dimaib/Autolevel_sensor/schematic_pcb/Big_PP_stm32/123.png

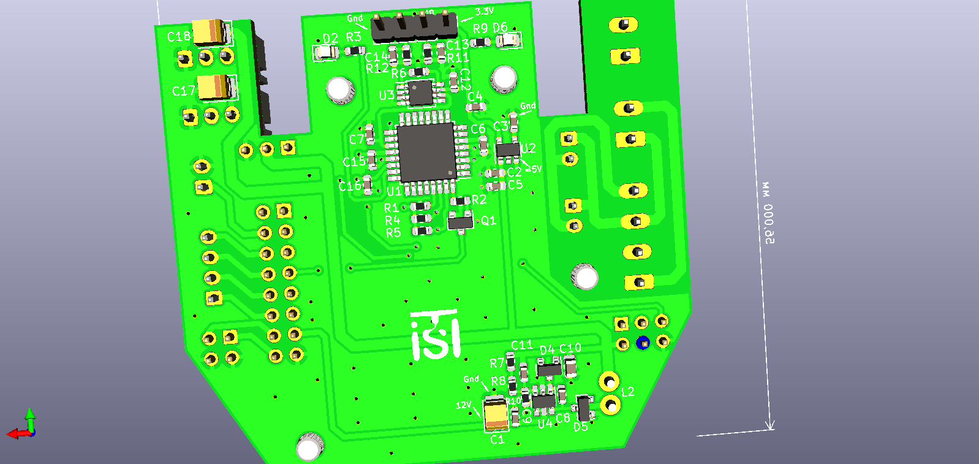
schematic_pcb/Big_PP_stm32/123.png
