dimaib/Autolevel_sensor/Программа INA333 AtSt_old/INA333/Output-Build.txt

------ Build started: Project: INA333, Configuration: Debug AVR ------
Build started.
Project "INA333.cproj" (default targets):
Target "PreBuildEvent" skipped, due to false condition; ('$(PreBuildEvent)'!='') was evaluated as (''!='').
Target "CoreBuild" in file "C:\Program Files (x86)\Atmel\Studio\7.0\Vs\Compiler.targets" from project "C:\Google Диск\02. Проекты_h\02. +3d_print\Датчик автоуровня\Программа INA333 AtSt\INA333\INA333\INA333.cproj" (target "Build" depends on it):
	Task "RunCompilerTask"
		Shell Utils Path C:\Program Files (x86)\Atmel\Studio\7.0\shellUtils
		C:\Program Files (x86)\Atmel\Studio\7.0\shellUtils\make.exe all --jobs 8 --output-sync 
		Building file: .././main.c
		Invoking: AVR/GNU C Compiler : 5.4.0
		"C:\Program Files (x86)\Atmel\Studio\7.0\toolchain\avr8\avr8-gnu-toolchain\bin\avr-gcc.exe"  -x c -funsigned-char -funsigned-bitfields -DDEBUG  -I"C:\Program Files (x86)\Atmel\Studio\7.0\Packs\atmel\ATmega_DFP\1.2.209\include"  -O1 -ffunction-sections -fdata-sections -fpack-struct -fshort-enums -g2 -Wall -mmcu=atmega8a -B "C:\Program Files (x86)\Atmel\Studio\7.0\Packs\atmel\ATmega_DFP\1.2.209\gcc\dev\atmega8a" -c -std=gnu99 -MD -MP -MF "main.d" -MT"main.d" -MT"main.o"   -o "main.o" ".././main.c" 
		Finished building: .././main.c
		Building target: INA333.elf
		Invoking: AVR/GNU Linker : 5.4.0
		"C:\Program Files (x86)\Atmel\Studio\7.0\toolchain\avr8\avr8-gnu-toolchain\bin\avr-gcc.exe" -o INA333.elf  main.o   -Wl,-Map="INA333.map" -Wl,--start-group -Wl,-lm  -Wl,--end-group -Wl,--gc-sections -mmcu=atmega8a -B "C:\Program Files (x86)\Atmel\Studio\7.0\Packs\atmel\ATmega_DFP\1.2.209\gcc\dev\atmega8a"  
		Finished building target: INA333.elf
		"C:\Program Files (x86)\Atmel\Studio\7.0\toolchain\avr8\avr8-gnu-toolchain\bin\avr-objcopy.exe" -O ihex -R .eeprom -R .fuse -R .lock -R .signature -R .user_signatures  "INA333.elf" "INA333.hex"
		"C:\Program Files (x86)\Atmel\Studio\7.0\toolchain\avr8\avr8-gnu-toolchain\bin\avr-size.exe" "INA333.elf"
		   text	   data	    bss	    dec	    hex	filename
		   2172	     30	      0	   2202	    89a	INA333.elf
	Done executing task "RunCompilerTask".
	Task "RunOutputFileVerifyTask"
				Program Memory Usage 	:	2202 bytes   26,9 % Full
				Data Memory Usage 		:	30 bytes   2,9 % Full
				Warning: Memory Usage estimation may not be accurate if there are sections other than .text sections in ELF file
	Done executing task "RunOutputFileVerifyTask".
Done building target "CoreBuild" in project "INA333.cproj".
Target "PostBuildEvent" skipped, due to false condition; ('$(PostBuildEvent)' != '') was evaluated as ('' != '').
Target "Build" in file "C:\Program Files (x86)\Atmel\Studio\7.0\Vs\Avr.common.targets" from project "C:\Google Диск\02. Проекты_h\02. +3d_print\Датчик автоуровня\Программа INA333 AtSt\INA333\INA333\INA333.cproj" (entry point):
Done building target "Build" in project "INA333.cproj".
Done building project "INA333.cproj".

Build succeeded.
========== Build: 1 succeeded or up-to-date, 0 failed, 0 skipped ==========
