dimaib/Autolevel_sensor/schematic_pcb/Big_PP_NEW_fix/Спецификация.xlsx

Спецификация платы экструдера
На схеме | Номинал | Артикул | Ссылка | Цена, шт | Кол-во | Кол-во комплектов | Цена, общ
C2 | 10uF | 293D106X9020B2TE3 | https://www.chipdip.ru/product0/8085431345 | 14.00 ₽ | 1 | 10 | 140.00 ₽
C3 | 20nF | GRM188R71H223KA01D | https://www.chipdip.ru/product/grm188r71h223k | 2.00 ₽ | 1 | 10 | 20.00 ₽
C4 | 470pF | GRM1885C1H471JA01D | https://www.chipdip.ru/product/grm1885c1h471j | 2.00 ₽ | 1 | 10 | 20.00 ₽
C5 | 0.1uF | GRM188R71H104KA93D | https://www.chipdip.ru/product/grm188r71h104k | 8.00 ₽ | 1 | 10 | 80.00 ₽
C6 | 22uF | GRM21BR60J226ME39L | https://www.chipdip.ru/product/grm21br60j226m | 10.00 ₽ | 1 | 10 | 100.00 ₽
C14 | 10uF | GRM188R61E106MA73D | https://www.chipdip.ru/product/grm188r61e106m | 12.00 ₽ | 1 | 10 | 120.00 ₽
> C1, C7-C12, C15 | 1uF | GRM188R61E105KAADD | https://www.chipdip.ru/product/grm188r61e105k | 5.00 ₽ | 8 | 10 | 400.00 ₽
D1 | Диод Шоттки | B340A-E3/61T | https://www.chipdip.ru/product/b340a-e3-61t-2 | 11.00 ₽ | 1 | 10 | 110.00 ₽
D2 | LED зелёный | GNL-3012GD | https://www.chipdip.ru/product/gnl-3012gd | 5.00 ₽ | 1 | 10 | 50.00 ₽
D3 | LED жёлтый | KP-2012EC | https://www.chipdip.ru/product/gnl-3012yd | 5.00 ₽ | 1 | 10 | 50.00 ₽
> D4, D5 | AD5160BRJZ | AD5160BRJZ10-R2 | https://www.chipdip.ru/product/ad5160brjz10-r2-2 | 110.00 ₽ | 2 | 10 | 2200.00 ₽
D6 | BAS321 | BAS321.115 | https://www.chipdip.ru/product/bas321.115 | 8.00 ₽ | 1 | 10 | 80.00 ₽
D7 | SP0503 | SP0503BAHTG | https://www.chipdip.ru/product1/8001783912 | 19.00 ₽ | 1 | 10 | 190.00 ₽
J15 | USB_B_Micro | USB/M-1J (DS1104) | https://www.chipdip.ru/product/usb-m-1j | 22.00 ₽ | 1 | 10 | 220.00 ₽
L1 | 3.3uH | RLB0914-3R3ML, 3.3 мкГн | https://www.chipdip.ru/product/rlb0914-3r3ml | 25.00 ₽ | 1 | 10 | 250.00 ₽
Q1 | BC817 | BC817-16.215 | https://www.chipdip.ru/product/bc817-16-nxp | 3.00 ₽ | 1 | 10 | 30.00 ₽
R1 | 150k | 0.1Вт 0603 150 кОм, 1% | https://www.chipdip.ru/product0/9000079764 | 0.90 ₽ | 1 | 10 | 9.00 ₽
R2 | 47k | 0.1Вт 0603 47 кОм, 1% | https://www.chipdip.ru/product0/9000079752 | 0.90 ₽ | 1 | 10 | 9.00 ₽
R3 | 24k | 0.1Вт 0603 24 кОм, 1% | https://www.chipdip.ru/product0/9000079745 | 0.90 ₽ | 1 | 10 | 9.00 ₽
R5 | 1.8k | 0.1Вт 0603 1.8 кОм, 1% | https://www.chipdip.ru/product0/9000079718 | 0.90 ₽ | 1 | 10 | 9.00 ₽
> R4, R6, R8, R10, R12 | 10k | 0.063Вт 0603 10 кОм, 1% | https://www.chipdip.ru/product0/9000079736 | 0.90 ₽ | 5 | 10 | 45.00 ₽
> R7, R9, R11 | 360 | 0.1Вт 0603 360 Ом, 1% | https://www.chipdip.ru/product0/9000079629 | 0.90 ₽ | 3 | 10 | 27.00 ₽
R13 | 82 | 0.1Вт 0603 82 Ом, 1% | https://www.chipdip.ru/product0/9000079614 | 0.90 ₽ | 1 | 10 | 9.00 ₽
RV1 | 10k | 3296W-1-103LF | https://www.chipdip.ru/product/3296w-1-103 | 70.00 ₽ | 1 | 10 | 700.00 ₽
RV2 | 100 | 3224W-1-101E | https://www.chipdip.ru/product/3224w-1-101e | 90.00 ₽ | 1 | 10 | 900.00 ₽
U1 | TPS54332 | TPS54332DDAR | https://www.chipdip.ru/product/tps54332dda | 96.00 ₽ | 1 | 10 | 960.00 ₽
U2 | AP1117-33 | AMS1117-3.3 | https://www.chipdip.ru/product/ams1117-3.3 | 16.00 ₽ | 1 | 10 | 160.00 ₽
U3 | ATmega8A-AU | ATmega8A-AU | https://www.chipdip.ru/product/atmega8a-au | 90.00 ₽ | 1 | 10 | 900.00 ₽
U4 | CP2102 | CP2102-GMR | https://www.chipdip.ru/product/cp2102-gmr | 110.00 ₽ | 1 | 10 | 1100.00 ₽
U5 | INA333 | INA333AIDGKT | https://www.chipdip.ru/product/ina333aidgkt | 180.00 ₽ | 1 | 10 | 1800.00 ₽
 |  |  |  |  |  | Итого: | 10697.00 ₽
