dimaib/Autolevel_sensor/schematic_pcb/Big_PP_stm32/_23.FCStd

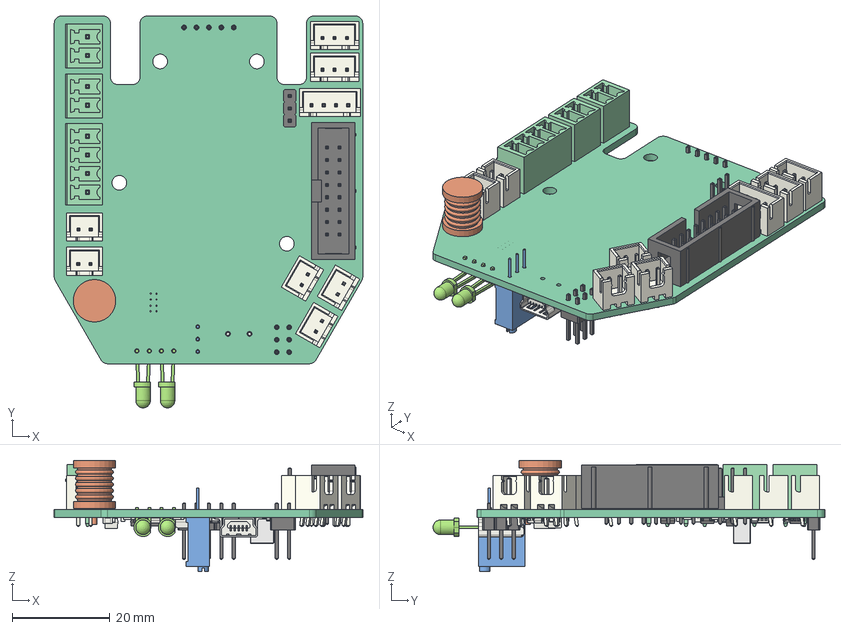
[picture p2: CAD file, 2022-04-17]
schematic_pcb/Big_PP_stm32/_23.FCStd
63.0 x 80.0 x 22.7 mm
Pcb
J3_IDC_Header_2x08_P254mm_Vertical_5DCC8D21
L1_L_Radial_D8.7mm_P5.00mm_Fastron_07HCP_5DCE0A41
J5_JST_B3B_XH_A_5DCC6F4B
J8_JST_B2B_XH_A_5DCD43AC
J7_JST_B2B_XH_A_5DCD4424
J1_JST_B3B_XH_A_5DCC6FC6
J4_JST_B4B_XH_A_5D9DB084
J6_JST_B2B_XH_A_5D9D945D
J9_PinHeader_1x03_P254mm_Vertical_5D88C4DF
J10_MCV_01x04_G_3_81mm_5D88C476
J11_MCV_01x02_G_3_81mm_5D88C444
J12_MCV_01x02_G_3_81mm_5D88C412
J13_JST_B2B_XH_A_5D88C3EA
J14_JST_B2B_XH_A_5D88C3C2
User Library-3224W
D2_LED_D3.0mm_Horizontal_O6.35mm_Z2.0mm_5DCFC488
D3_LED_D3.0mm_Horizontal_O6.35mm_Z2.0mm_5DCD08B7
J2_PinHeader_2x03_P254mm_Vertical_5D88C5C6
D1_D_SMA_5DCE03F9
RV1_Potentiometer_Bourns_3296W_Vertical_5D9DDB35
U1_HTSOP_8_1EP_39x49mm_Pitch127mm_5DCE0D9C
R5_R_0603_1608Metric_5DCE0B9E
R4_R_0603_1608Metric_5DCE0B6D
R3_R_0603_1608Metric_5DCE0B5C
R2_R_0603_1608Metric_5DCE0B4B
R1_R_0603_1608Metric_5DCE88ED
C6_C_0805_2012Metric_5DD0618A
C5_C_0603_1608Metric_5DCE031E
C4_C_0603_1608Metric_5DCE030D
C3_C_0603_1608Metric_5DCE02BC
C2_CP_EIA_3528_21_Kemet_B_5DCE02AB
C1_C_0603_1608Metric_5DCE0298
U4_QFN-28-1EP_5x5mm_Pitch0.5mm_5DCD5544
U2_SOT_223_5DCD10CD
U5_MSOP_8_3x3mm_P065mm_5DCD10B7
U3_TQFP_32_7x7mm_P08mm_5DCD109A
R12_R_0603_1608Metric_5DCD0FB4
R7_R_0603_1608Metric_5DCFBE54
R13_R_0603_1608Metric_5DCD0F5F
R11_R_0603_1608Metric_5DCD0F4E
R10_R_0603_1608Metric_5DCD0F3D
R8_R_0603_1608Metric_5DCD0F2C
R9_R_0603_1608Metric_5DCF8C16
R6_R_0603_1608Metric_5DCD0F0A
Q1_SOT_23_5DD02543
D5_SOT_23_8_5DCD0942
D4_SOT_23_8_5DCFCF1D
D7_SOT_143_5DCD0912
D6_D_SOD_323_5DCD08A4
C11_C_0603_1608Metric_5DCD0846
C9_C_0603_1608Metric_5DCD0835
C8_C_0603_1608Metric_5DCD0824
C15_C_0603_1608Metric_5DCD0802
C7_C_0603_1608Metric_5DCD07F1
C10_C_0603_1608Metric_5DCD07CF
C12_C_0603_1608Metric_5DCFD2F7
C14_C_0603_1608Metric_5DCD07AD
J16_PinHeader_1x05_P254mm_Vertical_5DCCF2F8
J15_USB_Mini-B_Lumberg_2486_01_Horizontal_5D88C16D
