dimaib/Autolevel_sensor/schematic_pcb/Big_PP/Схема.pdf

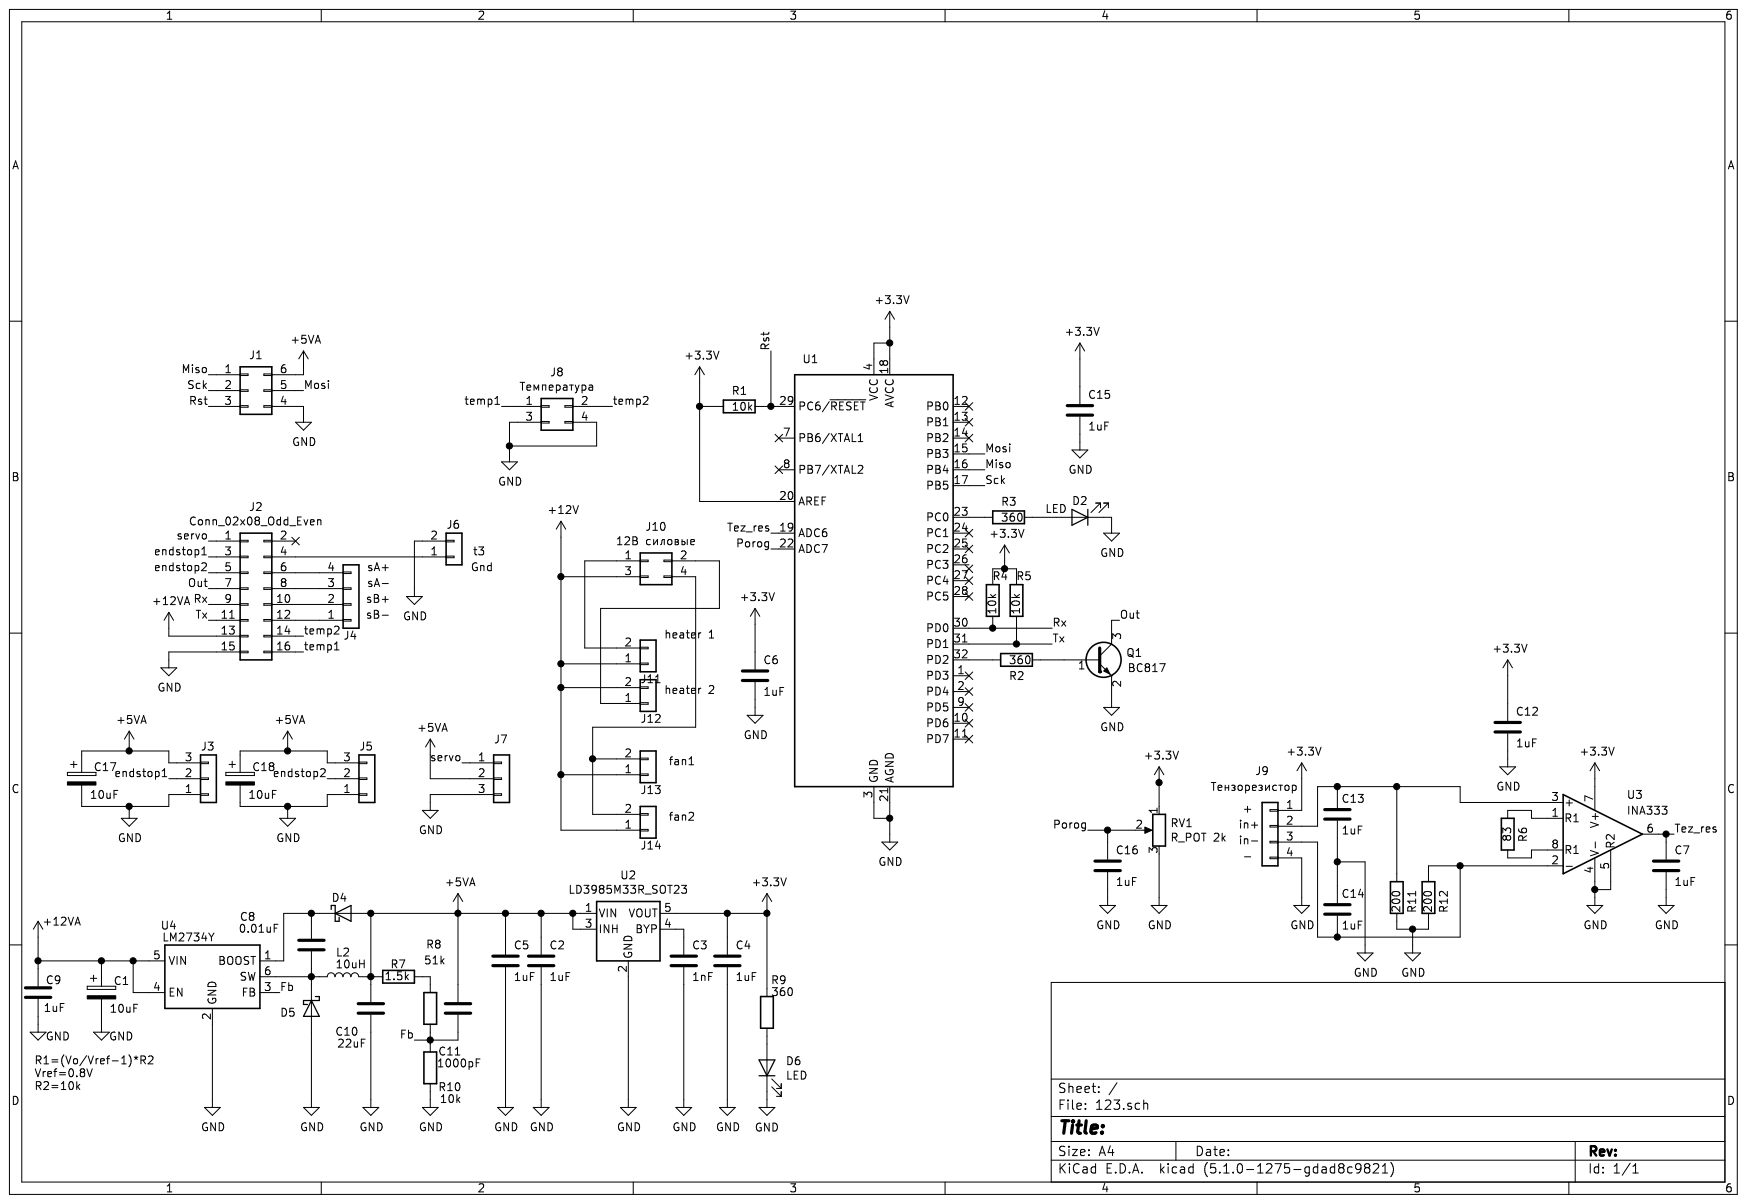
[picture p3: page 1]
