dimaib/Autolevel_sensor/(list of files, drawings)

Other design files:
Программа INA333 AtSt_old/test.DSN
