dimaib/Autolevel_sensor/schematic_pcb/Big_PP/123.kicad_pcb

## KiCad design schematic_pcb/Big_PP/123.kicad_pcb (2022-04-17)

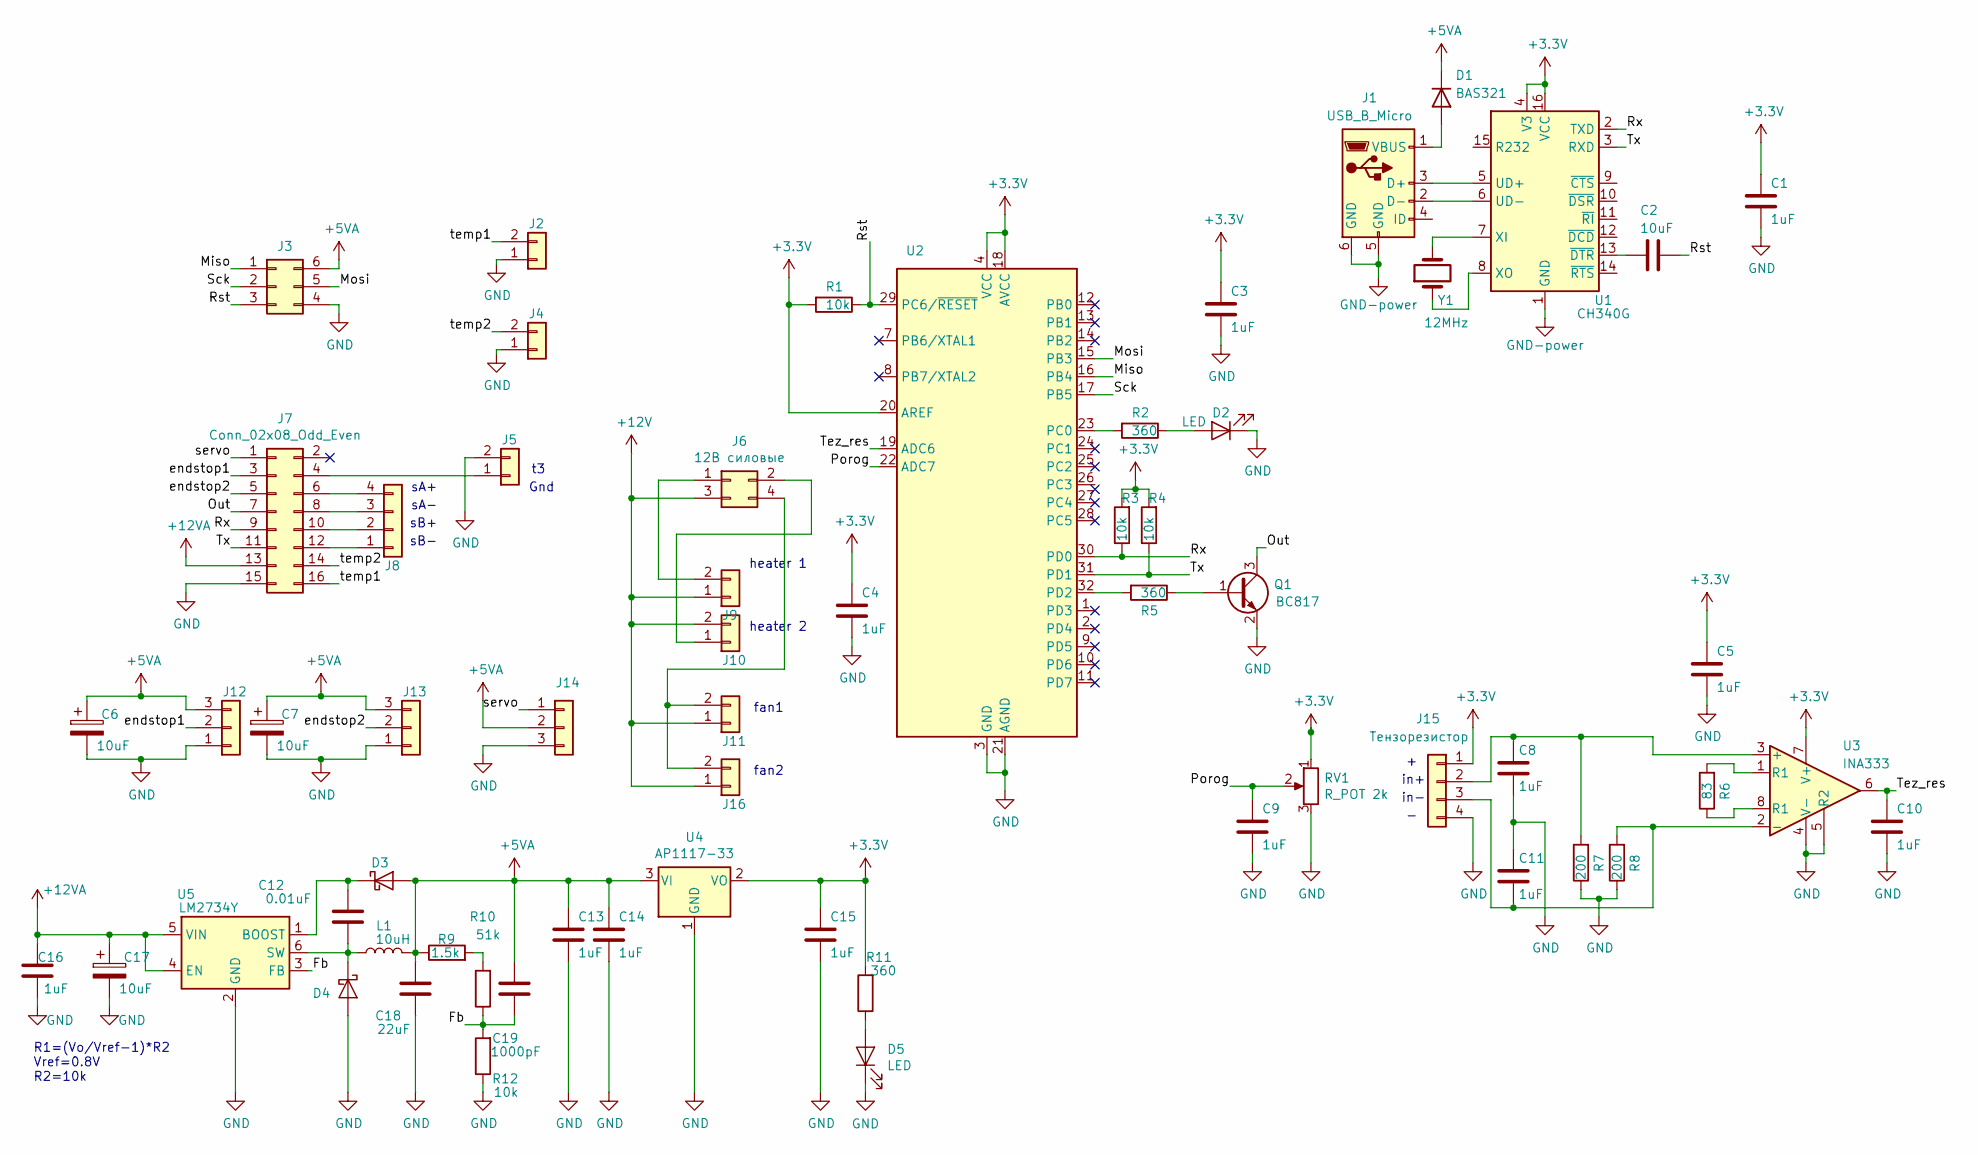
[picture p4: schematic 123.sch]

Parts:
C1, C3, C4, C5, C8, C9, C10, C11, C13, C14, C15, C16: 1uF; C_0603_1608Metric
C2: 10uF; C_0603_1608Metric
C6, C7, C17: 10uF; CP_EIA-3528-21_Kemet-B
C12: 0.01uF; C_0603_1608Metric
C18: 22uF; C_0805_2012Metric
C19: 1000pF; C_0603_1608Metric
D1: BAS321; D_SOD-323_HandSoldering
D2, D5: LED; LED_0805_2012Metric
D3, D4: Диод Шоттки; D_SOT-23_ANK
J1: USB_B_Micro; USB_Mini-B_Lumberg_2486_01_Horizontal
J2, J4, J5, J11, J16: Conn_01x02; JST_XH_B2B-XH-A_1x02_P2.50mm_Vertical
J3: Conn_02x03_Counter_Clockwise; PinHeader_2x03_P2.54mm_Vertical
J6: 12В силовые; PhoenixContact_MCV_1,5_4-G-3.81_1x04_P3.81mm_Vertical
J7: Conn_02x08_Odd_Even; IDC-Header_2x08_P2.54mm_Vertical
J8: Conn_01x04; JST_XH_B4B-XH-A_1x04_P2.50mm_Vertical
J9, J10: Conn_01x02; PhoenixContact_MCV_1,5_2-G-3.81_1x02_P3.81mm_Vertical
J12, J13: Conn_01x03; JST_XH_B3B-XH-A_1x03_P2.50mm_Vertical
J14: Conn_01x03; PinHeader_1x03_P2.54mm_Vertical
J15: Тензорезистор; PinHeader_1x04_P2.54mm_Vertical
L1: 10uH; L_Radial_D7.0mm_P3.00mm
Q1: BC817; SOT-23
R1, R3, R4, R12: 10k; R_0603_1608Metric
R2, R5, R11: 360; R_0603_1608Metric
R6: 83; R_0603_1608Metric
R7, R8: 200; R_0603_1608Metric
R9: 1.5k; R_0603_1608Metric
R10: 51k; R_0603_1608Metric
RV1: R_POT 2k; 3224W
U1: CH340G; SOIC-16_3.9x9.9mm_P1.27mm
U2: ATmega8A-AU; TQFP-32_7x7mm_P0.8mm
U3: INA333; MSOP-8_3x3mm_P0.65mm
U4: AP1117-33; SOT-223-3_TabPin2
U5: LM2734Y; TSOT-23-6
Y1: 12MHz; Crystal_SMD_3225-4Pin_3.2x2.5mm_HandSoldering

Connections:
+3V3: C1.1, C3.1, C4.1, C5.1, C15.1, J15.1, R1.2, R3.2, R4.2, R11.2, RV1.1, U1.4 (V3), U1.16 (VCC), U2.4 (VCC), U2.6 (VCC), U2.18 (AVCC), U2.20 (AREF), U3.7 (V+), U4.2 (VO)
+5VA: C6.1, C7.1, C13.1, C14.1, C18.2, C19.2, D1.2 (K), D3.2 (A), J3.6, J12.3, J13.3, J14.2, L1.2, R9.1, U4.3 (VI)
+12V: J6.3, J9.1, J10.2, J11.1, J16.1
+12VA: C16.2, C17.1, J7.13, U5.4 (EN), U5.5 (VIN)
/Fb: C19.1, R10.1, R12.2, U5.3 (FB)
/Miso: J3.1, U2.16 (PB4)
/Mosi: J3.5, U2.15 (PB3)
/Out: J7.7, Q1.3 (C)
/Porog: C9.1, RV1.2, U2.22 (ADC7)
/Rst: C2.1, J3.3, R1.1, U2.29 (PC6/~RESET)
/Rx: J7.9, R3.1, U1.2 (TXD), U2.30 (PD0)
/Sck: J3.2, U2.17 (PB5)
/Tez_res: C10.1, U2.19 (ADC6), U3.6
/Tx: J7.11, R4.1, U1.3 (RXD), U2.31 (PD1)
/endstop1: J7.3, J12.2
/endstop2: J7.5, J13.2
/servo: J7.1, J14.1
/temp1: J2.2, J7.16
/temp2: J4.2, J7.14
unnamed: C2.2, U1.13 (~DTR)
unnamed: C8.1, J15.2, R7.2, U3.3 (+)
unnamed: C11.2, J15.3, R8.2, U3.2 (-)
unnamed: C12.1, D4.1 (K), L1.1, U5.6 (SW)
unnamed: C12.2, D3.1 (K), U5.1 (BOOST)
unnamed: D1.1 (A), J1.1 (VBUS)
unnamed: D2.2 (A), R2.1
unnamed: D5.2 (A), R11.1
unnamed: J1.2 (D-), U1.6 (UD-)
unnamed: J1.3 (D+), U1.5 (UD+)
unnamed: J5.1, J7.4
unnamed: J6.1, J9.2
unnamed: J7.6, J8.4
unnamed: J7.8, J8.3
unnamed: J7.10, J8.2
unnamed: J7.12, J8.1
unnamed: J6.2, J10.1
unnamed: J6.4, J11.2, J16.2
unnamed: Q1.1 (B), R5.1
unnamed: R2.2, U2.23 (PC0)
unnamed: R5.2, U2.32 (PD2)
unnamed: R6.1, U3.8 (R1)
unnamed: R6.2, U3.1 (R1)
unnamed: R9.2, R10.2
unnamed: U1.7 (XI), Y1.2
unnamed: U1.8 (XO), Y1.1

Notes on the sheet:
fan1
fan2
heater 1
heater 2
sA+
sA-
sB+
sB-
Gnd
in+
in-
R1=(Vo/Vref-1)*R2 Vref=0.8V R2=10k

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
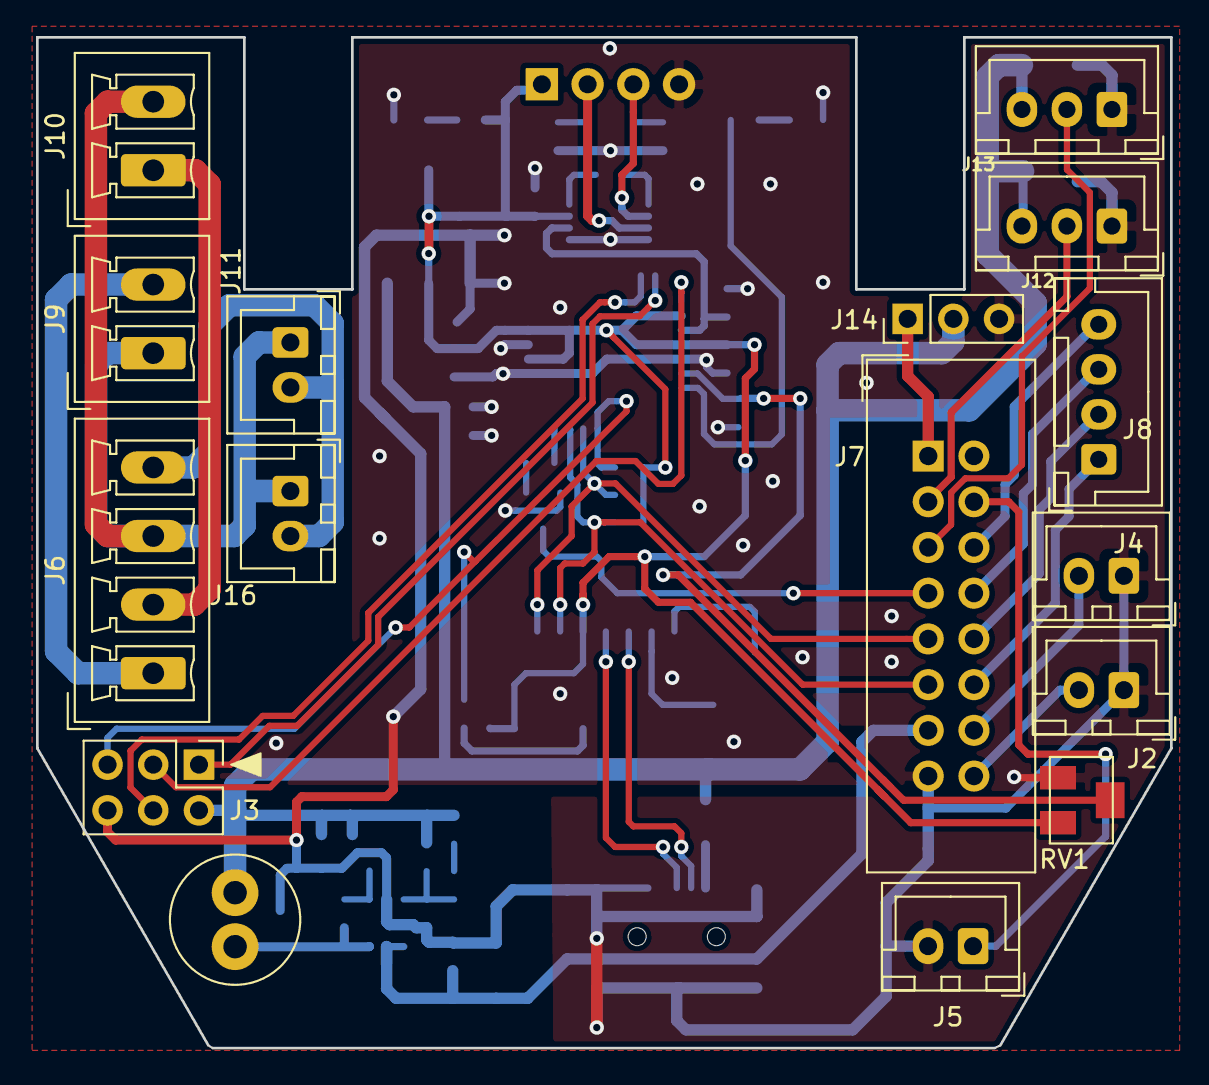
[picture p5: board schematic_pcb/Big_PP/123.kicad_pcb from above]

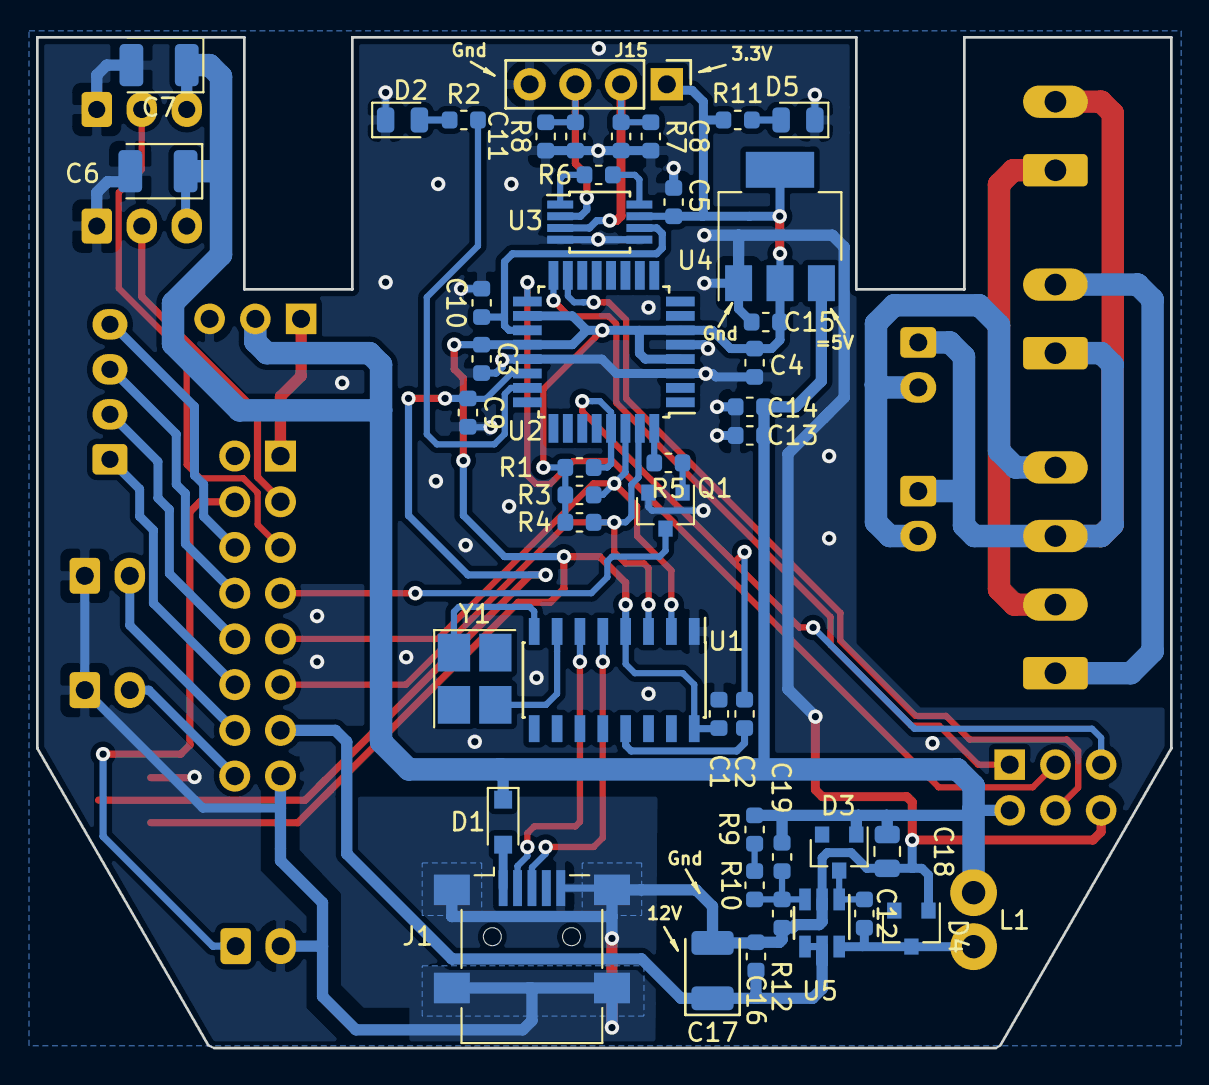
[picture p6: board schematic_pcb/Big_PP/123.kicad_pcb from below]

Board: 2 copper layers, 63.0 x 56.2 mm, 61 parts (45 on the bottom side), 46 nets.
