dimaib/Autolevel_sensor/schematic_pcb/Big_PP_NEW/123.kicad_pcb

## KiCad design schematic_pcb/Big_PP_NEW/123.kicad_pcb (2022-04-17)

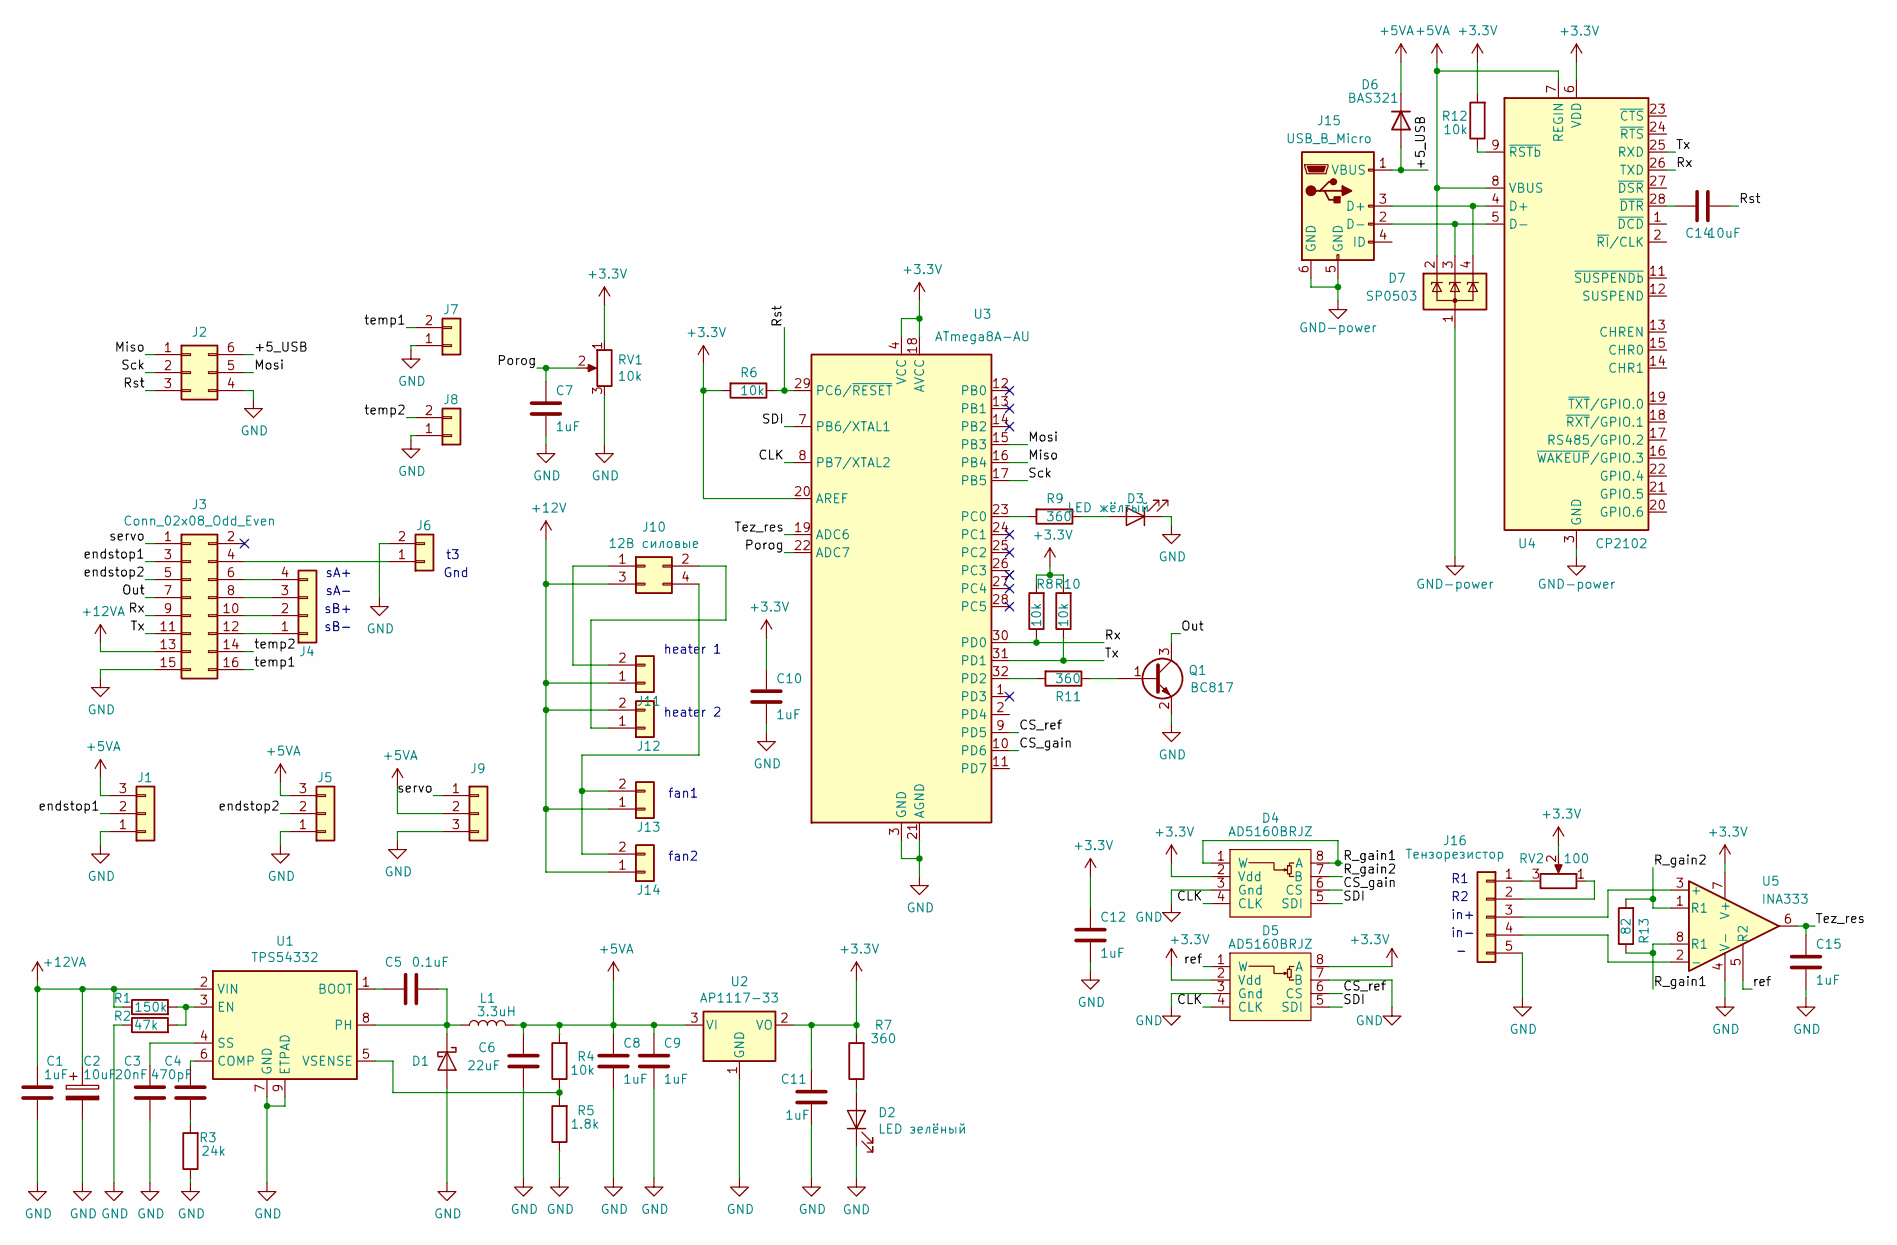
[picture p7: schematic 123.sch]

Parts:
C1, C7, C8, C9, C10, C11, C12, C15: 1uF; C_0603_1608Metric
C2: 10uF; CP_EIA-3528-21_Kemet-B
C3: 20nF; C_0603_1608Metric
C4: 470pF; C_0603_1608Metric
C5: 0.1uF; C_0603_1608Metric
C6: 22uF; C_0805_2012Metric
C14: 10uF; C_0603_1608Metric
D1: Диод Шоттки; D_SMA
D2: LED зелёный; LED_D3.0mm_Horizontal_O6.35mm_Z2.0mm
D3: LED жёлтый; LED_D3.0mm_Horizontal_O6.35mm_Z2.0mm
D4, D5: AD5160BRJZ; SOT-23-8
D6: BAS321; D_SOD-323_HandSoldering
D7: SP0503; SOT-143
J1, J5: Conn_01x03; JST_XH_B3B-XH-A_1x03_P2.50mm_Vertical
J2: Conn_02x03_Counter_Clockwise; PinHeader_2x03_P2.54mm_Vertical
J3: Conn_02x08_Odd_Even; IDC-Header_2x08_P2.54mm_Vertical
J4: Conn_01x04; JST_XH_B4B-XH-A_1x04_P2.50mm_Vertical
J6, J7, J8, J13, J14: Conn_01x02; JST_XH_B2B-XH-A_1x02_P2.50mm_Vertical
J9: Conn_01x03; PinHeader_1x03_P2.54mm_Vertical
J10: 12В силовые; PhoenixContact_MCV_1,5_4-G-3.81_1x04_P3.81mm_Vertical
J11, J12: Conn_01x02; PhoenixContact_MCV_1,5_2-G-3.81_1x02_P3.81mm_Vertical
J15: USB_B_Micro; USB_Mini-B_Lumberg_2486_01_Horizontal
J16: Тензорезистор; PinHeader_1x05_P2.54mm_Vertical
L1: 3.3uH; L_Radial_D8.7mm_P5.00mm_Fastron_07HCP
Q1: BC817; SOT-23
R1: 150k; R_0603_1608Metric
R2: 47k; R_0603_1608Metric
R3: 24k; R_0603_1608Metric
R4, R6, R8, R10, R12: 10k; R_0603_1608Metric
R5: 1.8k; R_0603_1608Metric
R7, R9, R11: 360; R_0603_1608Metric
R13: 82; R_0603_1608Metric
RV1: 10k; Potentiometer_Bourns_3296W_Vertical
RV2: 100; 3224W
U1: TPS54332; TI_SO-PowerPAD-8_ThermalVias
U2: AP1117-33; SOT-223-3_TabPin2
U3: ATmega8A-AU; TQFP-32_7x7mm_P0.8mm
U4: CP2102; QFN-28-1EP_5x5mm_P0.5mm_EP3.35x3.35mm
U5: INA333; MSOP-8_3x3mm_P0.65mm

Connections:
+3V3: C10.1, C11.1, C12.1, D4.2 (Vdd), D5.2 (Vdd), D5.8 (A), R6.2, R7.2, R8.2, R10.2, R12.2, RV1.1, RV2.2, U2.2 (VO), U3.4 (VCC), U3.6 (VCC), U3.18 (AVCC), U3.20 (AREF), U4.6 (VDD), U5.7 (V+)
+5VA: C6.2, C8.1, C9.1, D6.2 (K), D7.2 (K), J1.3, J5.3, J9.2, L1.2, R4.2, U2.3 (VI), U4.7 (REGIN), U4.8 (VBUS)
+12V: J10.3, J11.1, J12.2, J13.1, J14.1
+12VA: C1.2, C2.1, J3.13, R1.1, U1.2 (VIN)
/+5_USB: D6.1 (A), J2.6, J15.1 (VBUS)
/CLK: D4.4 (CLK), D5.4 (CLK), U3.8 (PB7/XTAL2)
/CS_gain: D4.6 (CS), U3.10 (PD6)
/CS_ref: D5.6 (CS), U3.9 (PD5)
/Miso: J2.1, U3.16 (PB4)
/Mosi: J2.5, U3.15 (PB3)
/Out: J3.7, Q1.3 (C)
/Porog: C7.1, RV1.2, U3.22 (ADC7)
/R_gain1: D4.1 (W), D4.8 (A), R13.1, U5.8 (R1)
/R_gain2: D4.7 (B), R13.2, U5.1 (R1)
/Rst: C14.1, J2.3, R6.1, U3.29 (PC6/~RESET)
/Rx: J3.9, R8.1, U3.30 (PD0), U4.26 (TXD)
/SDI: D4.5 (SDI), D5.5 (SDI), U3.7 (PB6/XTAL1)
/Sck: J2.2, U3.17 (PB5)
/Tez_res: C15.1, U3.19 (ADC6), U5.6
/Tx: J3.11, R10.1, U3.31 (PD1), U4.25 (RXD)
/endstop1: J1.2, J3.3
/endstop2: J3.5, J5.2
/ref: D5.1 (W), U5.5 (R2)
/servo: J3.1, J9.1
/temp1: J3.16, J7.2
/temp2: J3.14, J8.2
unnamed: C3.1, U1.4 (SS)
unnamed: C4.1, U1.6 (COMP)
unnamed: C4.2, R3.2
unnamed: C5.1, D1.1 (K), L1.1, U1.8 (PH)
unnamed: C5.2, U1.1 (BOOT)
unnamed: C14.2, U4.28 (~DTR)
unnamed: D2.2 (A), R7.1
unnamed: D3.2 (A), R9.1
unnamed: D7.3 (K), J15.2 (D-), U4.5 (D-)
unnamed: D7.4 (K), J15.3 (D+), U4.4 (D+)
unnamed: J3.4, J6.1
unnamed: J3.6, J4.4
unnamed: J3.8, J4.3
unnamed: J3.10, J4.2
unnamed: J3.12, J4.1
unnamed: J10.1, J11.2
unnamed: J10.2, J12.1
unnamed: J10.4, J13.2, J14.2
unnamed: J16.1, RV2.3
unnamed: J16.2, RV2.1
unnamed: J16.3, U5.3 (+)
unnamed: J16.4, U5.2 (-)
unnamed: Q1.1 (B), R11.1
unnamed: R1.2, R2.2, U1.3 (EN)
unnamed: R4.1, R5.2, U1.5 (VSENSE)
unnamed: R9.2, U3.23 (PC0)
unnamed: R11.2, U3.32 (PD2)
unnamed: R12.1, U4.9 (~RSTb)

Notes on the sheet:
fan1
fan2
heater 1
heater 2
sA+
sA-
sB+
sB-
Gnd
in+
in-

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
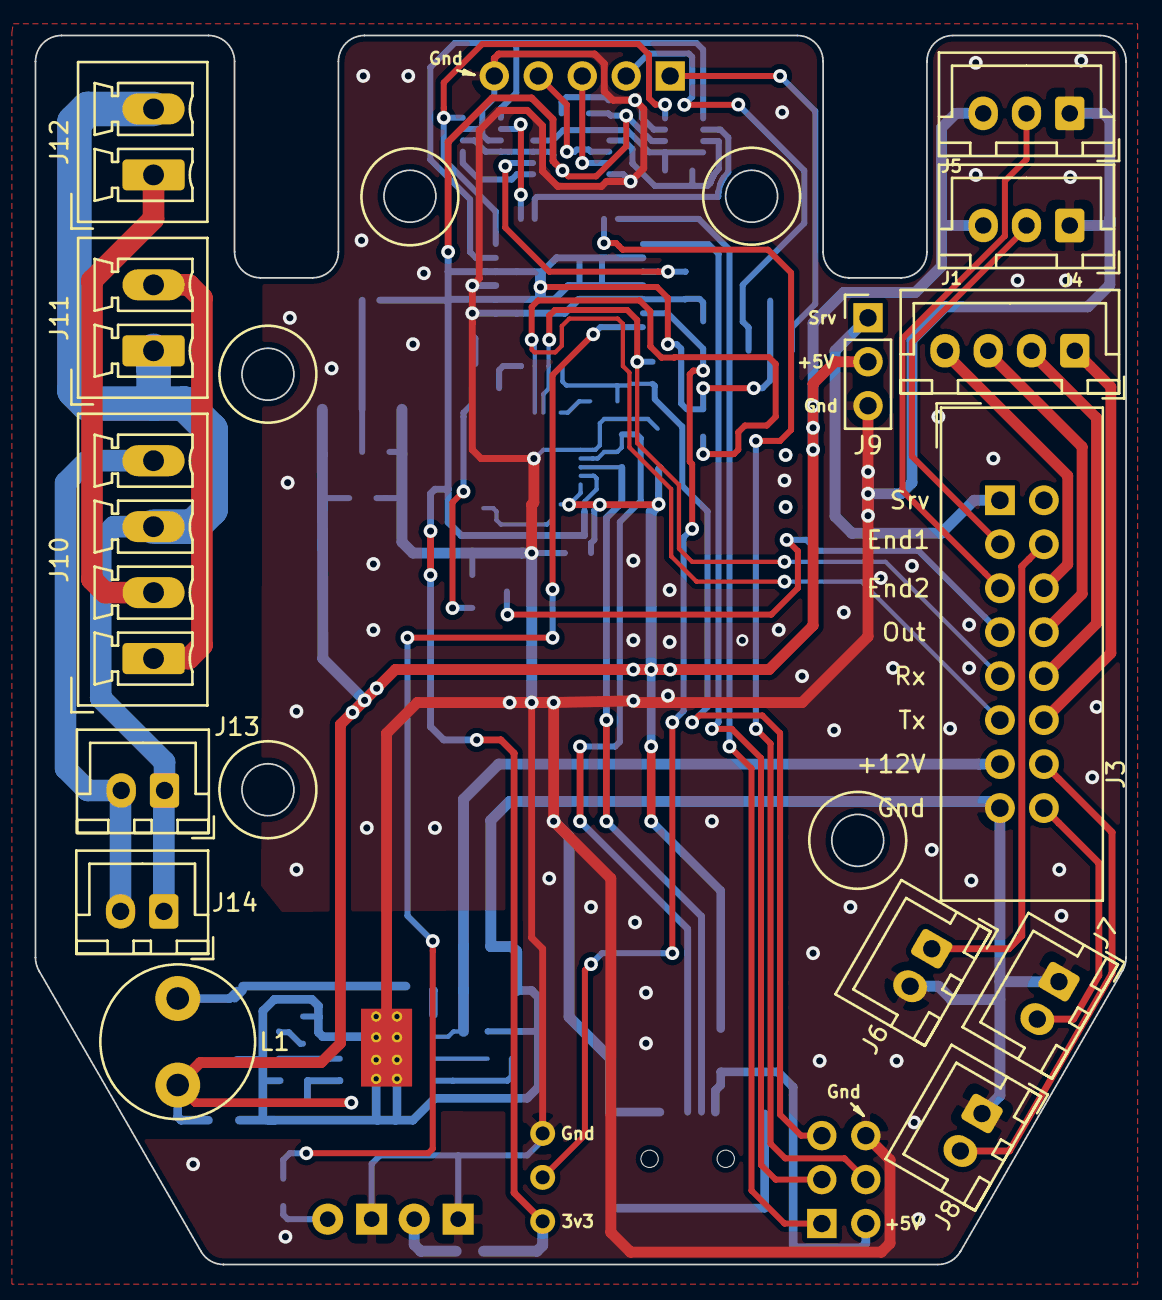
[picture p8: board schematic_pcb/Big_PP_NEW/123.kicad_pcb from above]

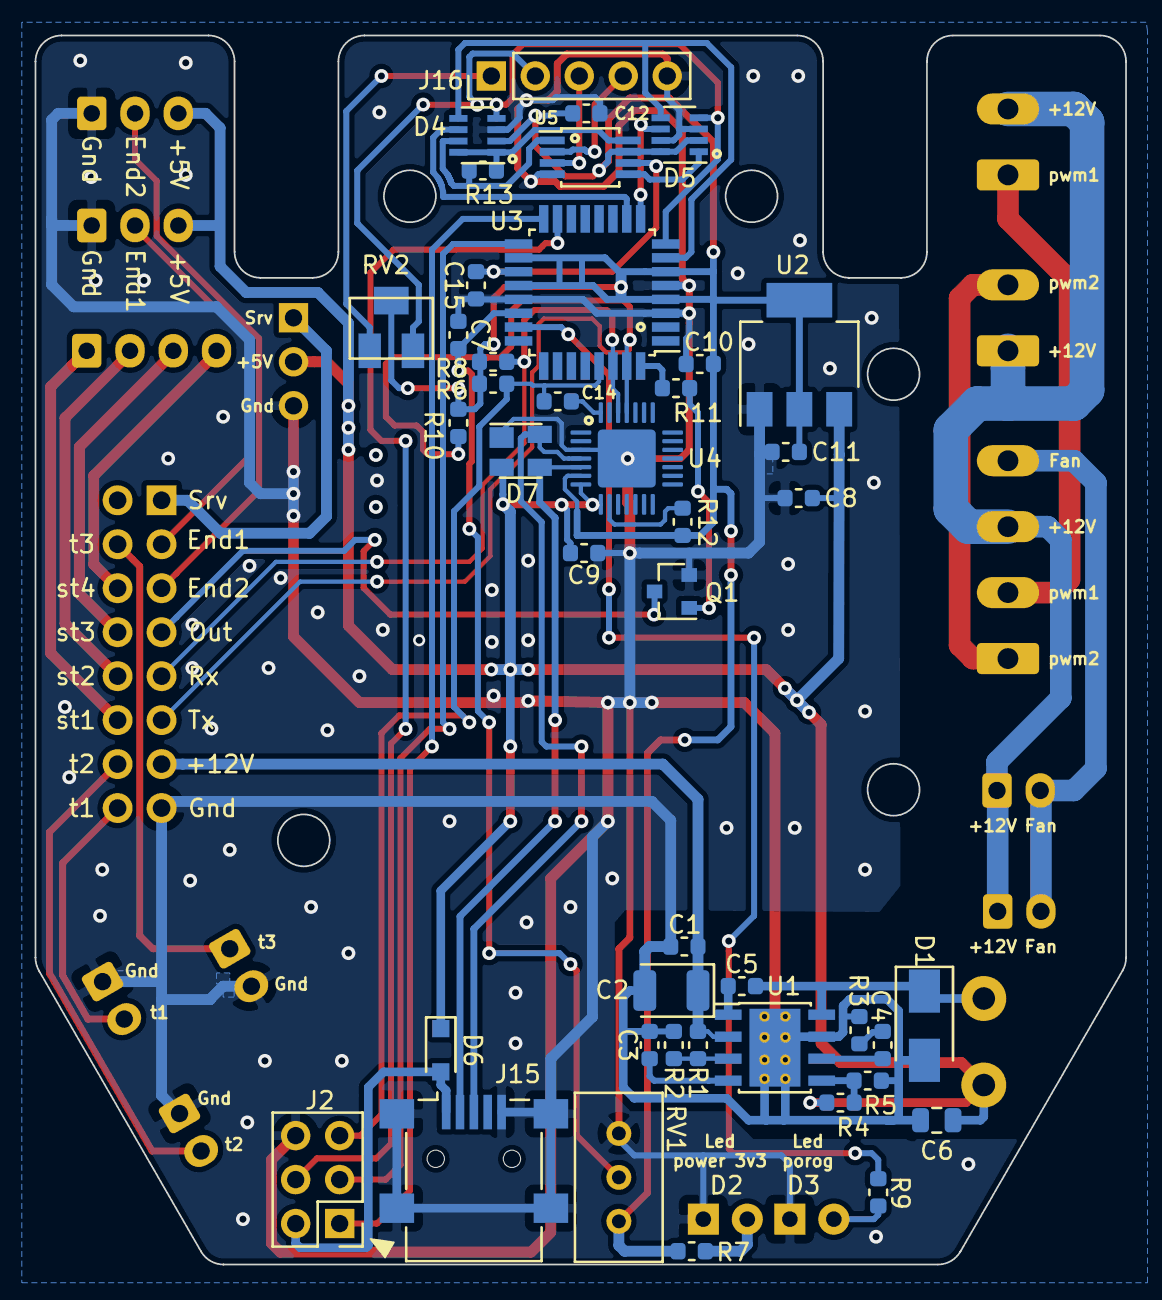
[picture p9: board schematic_pcb/Big_PP_NEW/123.kicad_pcb from below]

Board: 2 copper layers, 63.0 x 71.0 mm, 59 parts (45 on the bottom side), 55 nets.
