dimaib/Autolevel_sensor/software_INA333_AtSt/auto_level/auto_level/adc.h

#ifndef ADC_H
#define ADC_H

#include <avr/io.h>

void init_adc();						//инициализация модуля АЦП
uint16_t adc_convert(uint8_t chanel);	//запуск преобразования и считывания значения преобразования

#endif	//ADC_H
